sailingaround/mppt/README.md

# Mppt with rs485 status output
This is a small circuit providing an mppt power converter with these requirements:

 - up to 60v input
 - charge two lead-acid batteries (24V) (one should also be possible)
 - up to 4A current
 - rs485 status output for board computer
