sailingaround/mppt/mppt.kicad_pcb

## KiCad design mppt.kicad_pcb (2017-03-02)

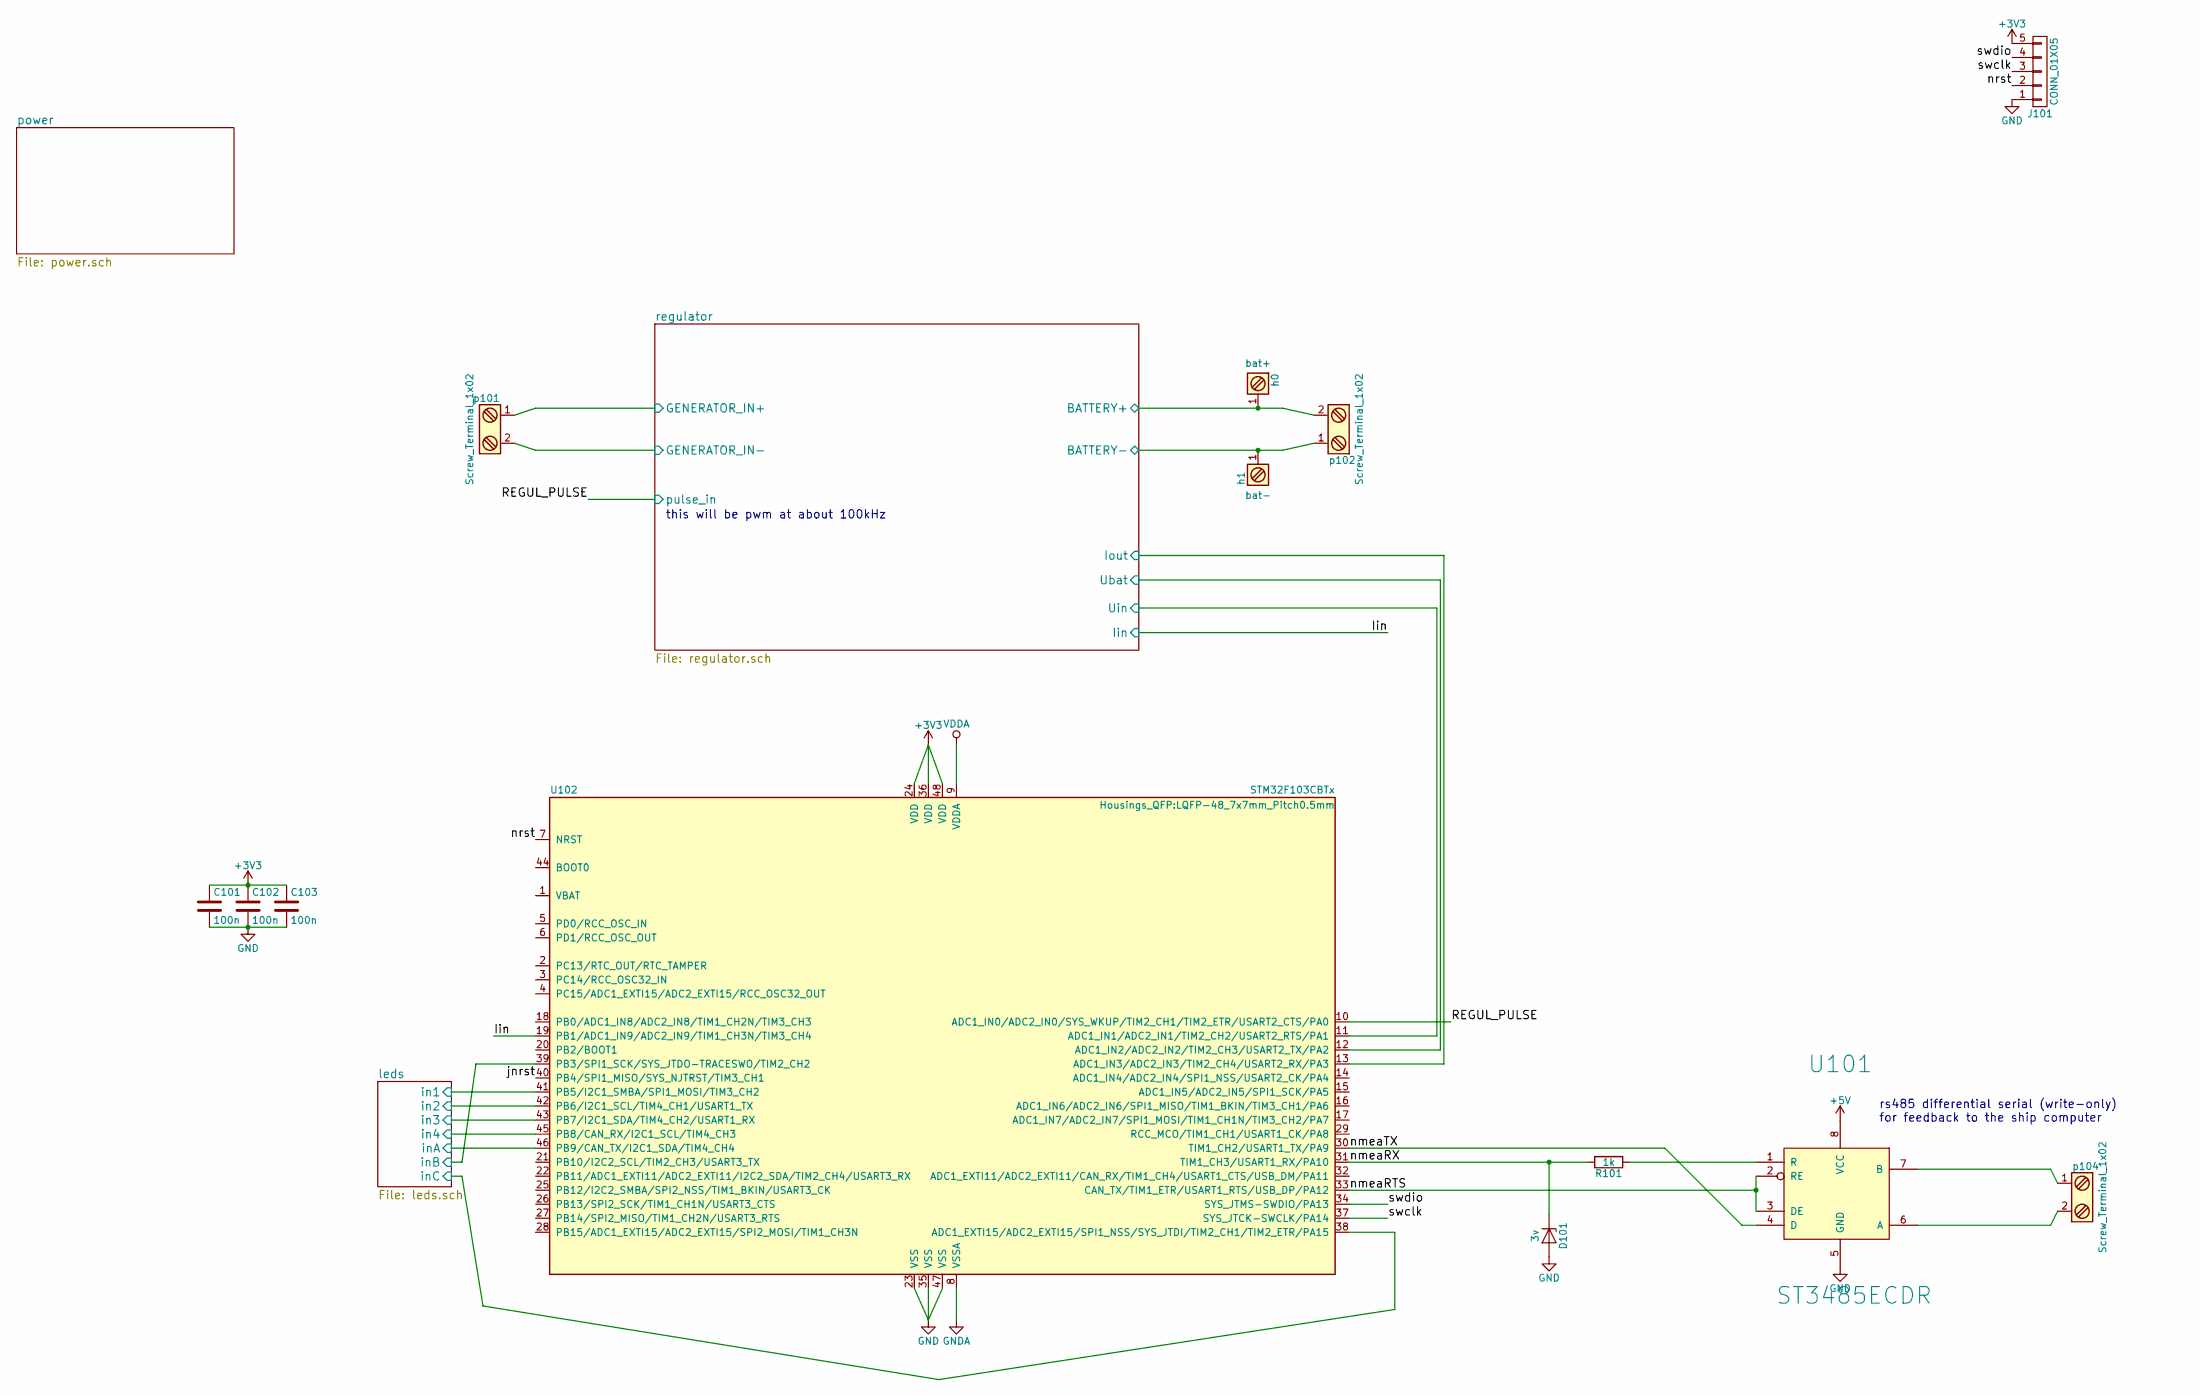
[picture p1: schematic mppt.sch]

Parts:
C101, C102, C103: 100n; C_0805
D101: 3v; D_SOD-323_HandSoldering; farnell 2441312
J101: CONN_01X05; swd_conn
R101: 1k; R_0805
U101: ST3485ECDR; SOIC-8_3.9x4.9mm_Pitch1.27mm; farnell 1842628
U102: STM32F103CBTx; LQFP-48_7x7mm_Pitch0.5mm
h0: bat+; m4_hole
h1: bat-; m4_hole
p101, p102, p104: Screw_Terminal_1x02; terminal

Connections:
+3V3: C101.1, C102.1, C103.1, J101.5, U102.24 (VDD), U102.36 (VDD), U102.48 (VDD); also elsewhere on the board
+5V: U101.8 (VCC); also elsewhere on the board
+24V: h0.1, p102.2; also elsewhere on the board
/Iin: U102.19 (PB1/ADC1_IN9/ADC2_IN9/TIM1_CH3N/TIM3_CH4); also elsewhere on the board
/REGUL_PULSE: U102.10 (ADC1_IN0/ADC2_IN0/SYS_WKUP/TIM2_CH1/TIM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); also elsewhere on the board
/leds/in1: U102.41 (PB5/I2C1_SMBA/SPI1_MOSI/TIM3_CH2); also elsewhere on the board
/leds/in2: U102.42 (PB6/I2C1_SCL/TIM4_CH1/USART1_TX); also elsewhere on the board
/leds/in3: U102.43 (PB7/I2C1_SDA/TIM4_CH2/USART1_RX); also elsewhere on the board
/leds/in4: U102.45 (PB8/CAN_RX/I2C1_SCL/TIM4_CH3); also elsewhere on the board
/leds/inA: U102.46 (PB9/CAN_TX/I2C1_SDA/TIM4_CH4); also elsewhere on the board
/leds/inB: U102.39 (PB3/SPI1_SCK/SYS_JTDO-TRACESWO/TIM2_CH2); also elsewhere on the board
/leds/inC: U102.38 (ADC1_EXTI15/ADC2_EXTI15/SPI1_NSS/SYS_JT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); also elsewhere on the board
/nmeaRTS: U101.2 (RE), U101.3 (DE), U102.33 (CAN_TX/TIM1_ETR/USART1_RTS/USB_DP/PA12)
/nmeaRX: D101.1 (K), R101.2, U102.31 (TIM1_CH3/USART1_RX/PA10)
/nmeaTX: U101.4 (D), U102.30 (TIM1_CH2/USART1_TX/PA9)
/nrst: J101.2, U102.7 (NRST)
/regulator/BATTERY-: h1.1, p102.1; also elsewhere on the board
/regulator/GENERATOR_IN+: p101.1; also elsewhere on the board
/regulator/GENERATOR_IN-: p101.2; also elsewhere on the board
/regulator/Iout: U102.13 (ADC1_IN3/ADC2_IN3/TIM2_CH4/USART2_RX/PA3); also elsewhere on the board
/regulator/Ubat: U102.12 (ADC1_IN2/ADC2_IN2/TIM2_CH3/USART2_TX/PA2); also elsewhere on the board
/regulator/Uin: U102.11 (ADC1_IN1/ADC2_IN1/TIM2_CH2/USART2_RTS/P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); also elsewhere on the board
/swclk: J101.3, U102.37 (SYS_JTCK-SWCLK/PA14)
/swdio: J101.4, U102.34 (SYS_JTMS-SWDIO/PA13)
GND: C101.2, C102.2, C103.2, D101.2 (A), J101.1, U101.5 (GND), U102.23 (VSS), U102.35 (VSS), U102.47 (VSS); also elsewhere on the board
GNDA: U102.8 (VSSA); also elsewhere on the board
unnamed: R101.1, U101.1 (R)
unnamed: U101.6 (A), p104.2
unnamed: U101.7 (B), p104.1
VDDA: U102.9 (VDDA); also elsewhere on the board

Notes on the sheet:
rs485 differential serial (write-only) for feedback to the ship computer
this will be pwm at about 100kHz

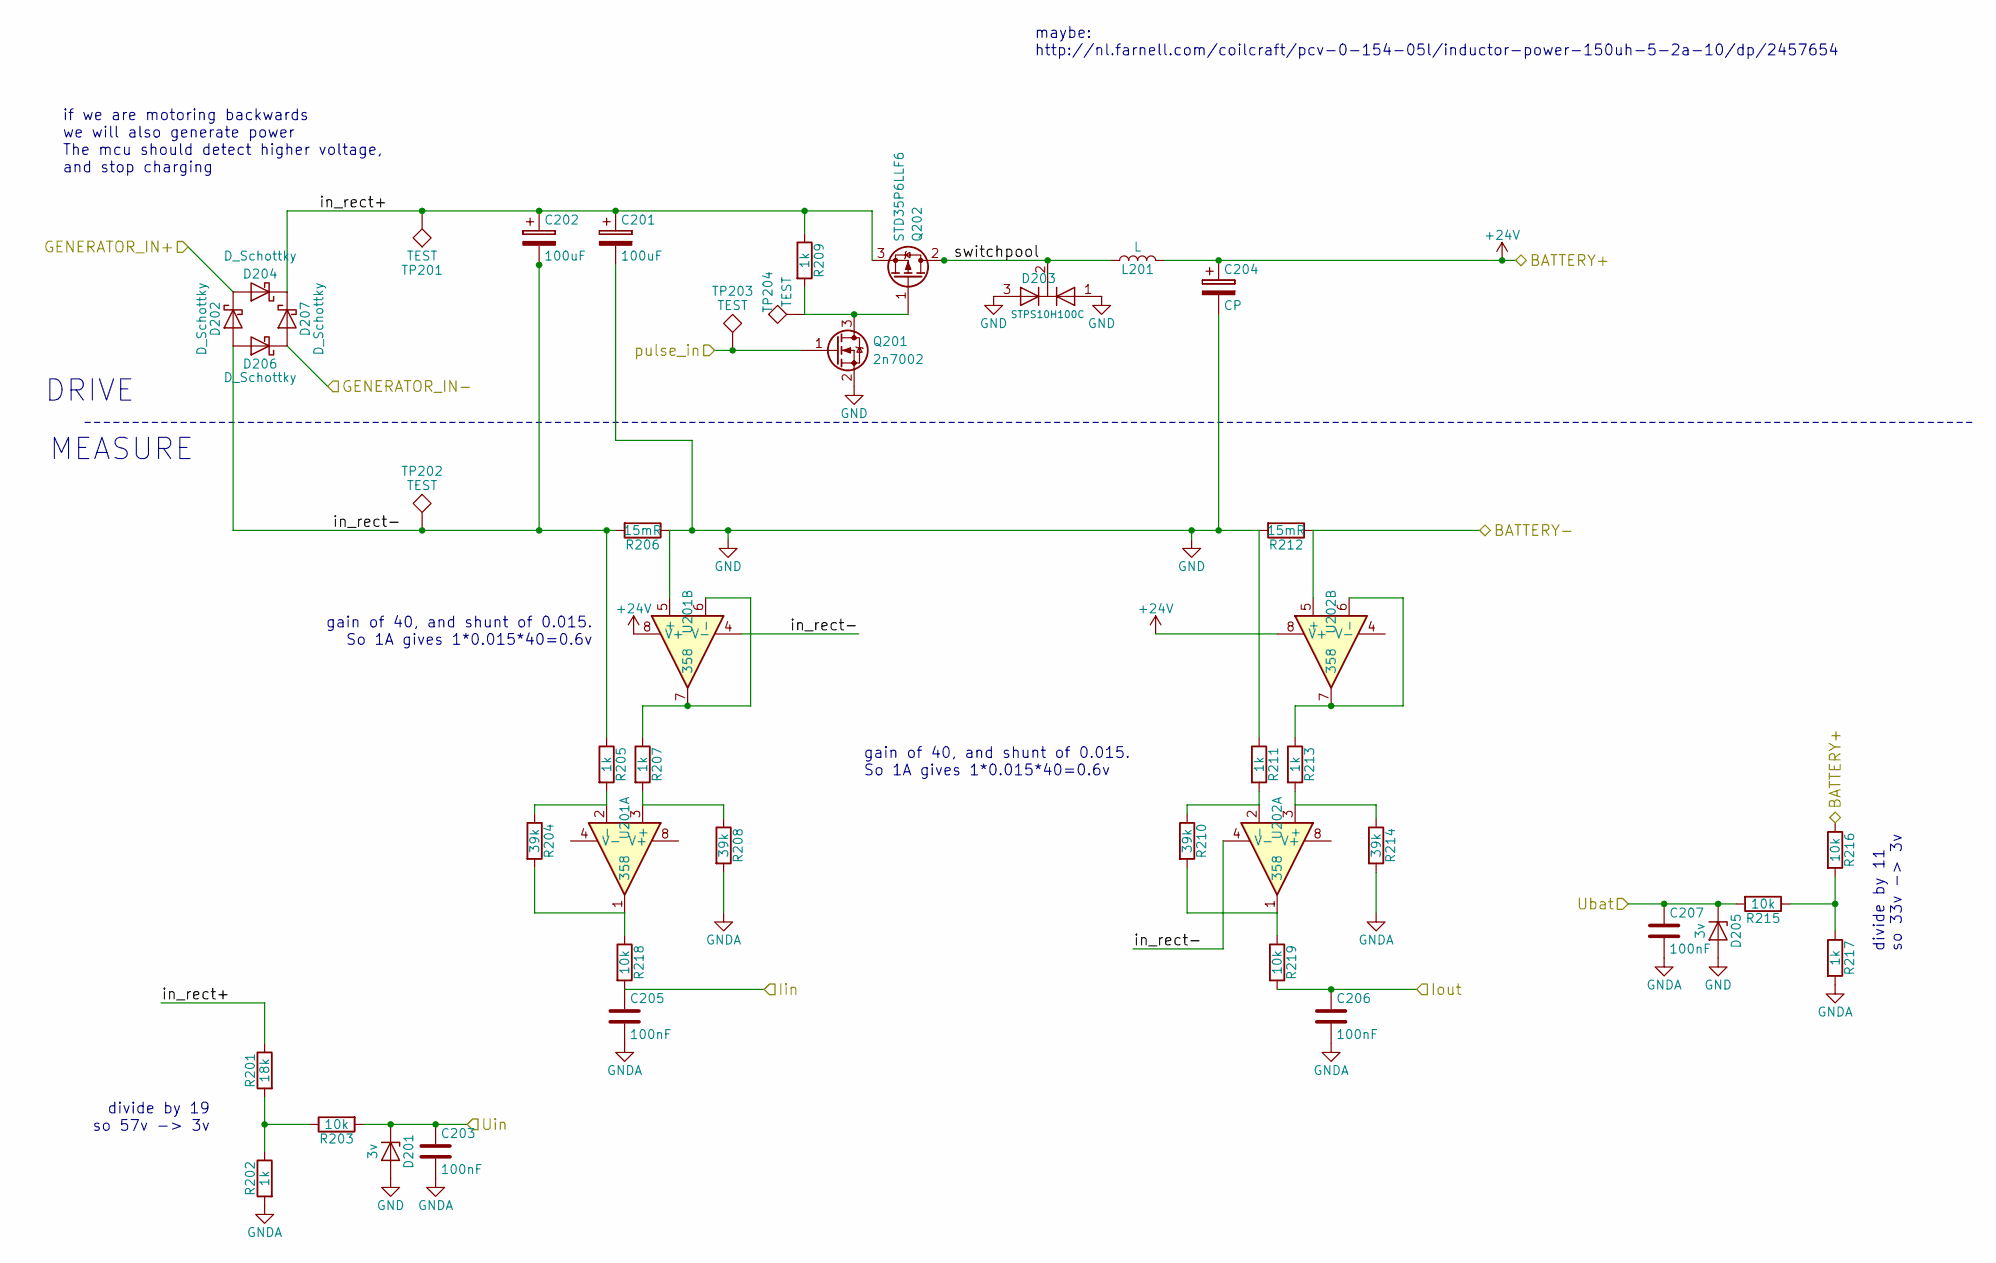
[picture p2: schematic regulator.sch]

Parts:
C201, C202: 100uF; CP_Radial_D10.0mm_P2.50mm; farnell 1281843
C203, C205, C206, C207: 100nF; C_0805
C204: CP; CP_Radial_D8.0mm_P5.00mm
D201, D205: 3v; D_SOD-323_HandSoldering; farnell 2441312
D202, D204, D206, D207: D_Schottky; Diode_DO-201AD_Vertical; farnell 1859669
D203: STPS10H100C; TO-220_Vertical
L201: L; toroid; farnell 1077015
Q201: 2n7002; SOT-23
Q202: STD35P6LLF6; TO-252-2Lead
R201: 18k; R_0805
R202, R205, R207, R209, R211, R213, R217: 1k; R_0805
R203, R215, R216, R218, R219: 10k; R_0805
R204, R208, R210, R214: 39k; R_0805
R206: 15mR; R_1206
R212: 15mR; R_1206_HandSoldering
TP201, TP202, TP203, TP204: TEST; Measurement_Point_Round-SMD-Pad_Big
U201, U202: 358; SOIC-8_3.9x4.9mm_Pitch1.27mm

Connections:
+24V: C204.1, L201.2, R216.1, U201.8 (V+), U202.8 (V+); also elsewhere on the board
/Iin: C205.1, R218.2; also elsewhere on the board
/REGUL_PULSE: Q201.1 (G), TP203.1; also elsewhere on the board
/regulator/BATTERY-: R212.1, U202.5 (+); also elsewhere on the board
/regulator/GENERATOR_IN+: D202.1 (K), D204.2 (A); also elsewhere on the board
/regulator/GENERATOR_IN-: D206.1 (K), D207.2 (A); also elsewhere on the board
/regulator/Iout: C206.1, R219.2; also elsewhere on the board
/regulator/Ubat: C207.1, D205.1 (K), R215.2; also elsewhere on the board
/regulator/Uin: C203.1, D201.1 (K), R203.2; also elsewhere on the board
/regulator/in_rect+: C201.1, C202.1, D204.1 (K), D207.1 (K), Q202.3 (S), R201.1, R209.1, TP201.1
/regulator/in_rect-: C202.2, D202.2 (A), D206.2 (A), R205.1, R206.2, TP202.1, U201.4 (V-), U202.4 (V-)
/regulator/switchpool: D203.2 (K), L201.1, Q202.2 (D)
GND: C201.2, C204.2, D201.2 (A), D203.1 (A), D203.3 (A), D205.2 (A), Q201.2 (S), R206.1, R211.1, R212.2, U201.5 (+); also elsewhere on the board
GNDA: C203.2, C205.2, C206.2, C207.2, R202.2, R208.2, R214.2, R217.2; also elsewhere on the board
unnamed: Q201.3 (D), Q202.1 (G), R209.2, TP204.1
unnamed: R201.2, R202.1, R203.1
unnamed: R204.1, R205.2, U201.2 (-)
unnamed: R204.2, R218.1, U201.1
unnamed: R207.1, U201.6 (-), U201.7
unnamed: R207.2, R208.1, U201.3 (+)
unnamed: R210.1, R211.2, U202.2 (-)
unnamed: R210.2, R219.1, U202.1
unnamed: R213.1, U202.6 (-), U202.7
unnamed: R213.2, R214.1, U202.3 (+)
unnamed: R215.1, R216.2, R217.1

Notes on the sheet:
divide by 19 so 57v -> 3v
if we are motoring backwards we will also generate power The mcu should detect higher voltage, and stop charging
divide by 11 so 33v -> 3v
DRIVE
MEASURE
gain of 40, and shunt of 0.015. So 1A gives 1*0.015*40=0.6v
maybe: http://nl.farnell.com/coilcraft/pcv-0-154-05l/inductor-power-150uh-5-2a-10/dp/2457654

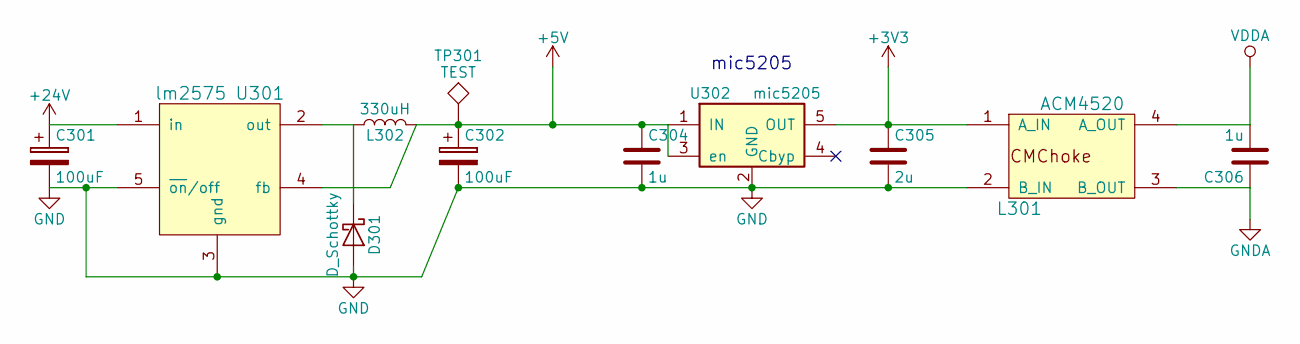
[picture p3: schematic power.sch]

Parts:
C301: 100uF; CP_Radial_D10.0mm_P2.50mm
C302: 100uF; CP_Radial_D8.0mm_P5.00mm
C304, C306: 1u; C_0805_HandSoldering
C305: 2u; C_0805_HandSoldering
D301: D_Schottky; D_DO-41_SOD81_P5.08mm_Vertical_KathodeUp
L301: ACM4520
L302: 330uH; 1212_inductor
TP301: TEST; Measurement_Point_Round-SMD-Pad_Big
U301: lm2575; TO-263-5Lead
U302: mic5205; SOT-23-5

Connections:
+3V3: C305.1, L301.1 (A_IN), U302.5 (OUT); also elsewhere on the board
+5V: C302.1, C304.1, L302.2, TP301.1, U301.4 (fb), U302.1 (IN), U302.3 (en); also elsewhere on the board
+24V: C301.1, U301.1 (in); also elsewhere on the board
GND: C301.2, C302.2, C304.2, C305.2, D301.2 (A), L301.2 (B_IN), U301.3 (gnd), U301.5 (~on~/off), U302.2 (GND); also elsewhere on the board
GNDA: C306.1, L301.3 (B_OUT); also elsewhere on the board
unnamed: D301.1 (K), L302.1, U301.2 (out)
VDDA: C306.2, L301.4 (A_OUT); also elsewhere on the board

Notes on the sheet:
mic5205

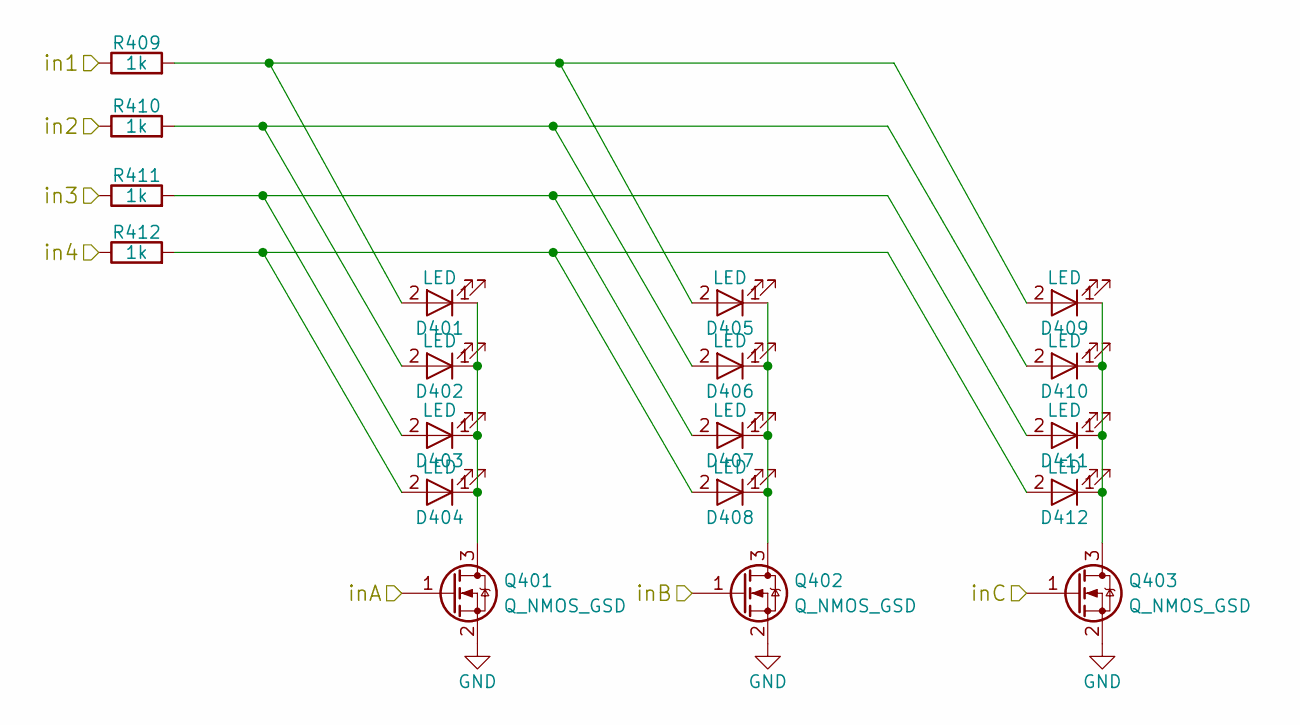
[picture p4: schematic leds.sch]

Parts:
D401, D402, D403, D404, D405, D406, D407, D408, D409, D410, D411, D412: LED; LED_0603
Q401, Q402, Q403: Q_NMOS_GSD; SOT-23_Handsoldering
R409, R410, R411, R412: 1k; R_0805

Connections:
/leds/in1: R409.1; also elsewhere on the board
/leds/in2: R410.1; also elsewhere on the board
/leds/in3: R411.1; also elsewhere on the board
/leds/in4: R412.1; also elsewhere on the board
/leds/inA: Q401.1 (G); also elsewhere on the board
/leds/inB: Q402.1 (G); also elsewhere on the board
/leds/inC: Q403.1 (G); also elsewhere on the board
GND: Q401.2 (S), Q402.2 (S), Q403.2 (S); also elsewhere on the board
unnamed: D401.1 (K), D402.1 (K), D403.1 (K), D404.1 (K), Q401.3 (D)
unnamed: D401.2 (A), D405.2 (A), D409.2 (A), R409.2
unnamed: D402.2 (A), D406.2 (A), D410.2 (A), R410.2
unnamed: D403.2 (A), D407.2 (A), D411.2 (A), R411.2
unnamed: D404.2 (A), D408.2 (A), D412.2 (A), R412.2
unnamed: D405.1 (K), D406.1 (K), D407.1 (K), D408.1 (K), Q402.3 (D)
unnamed: D409.1 (K), D410.1 (K), D411.1 (K), D412.1 (K), Q403.3 (D)

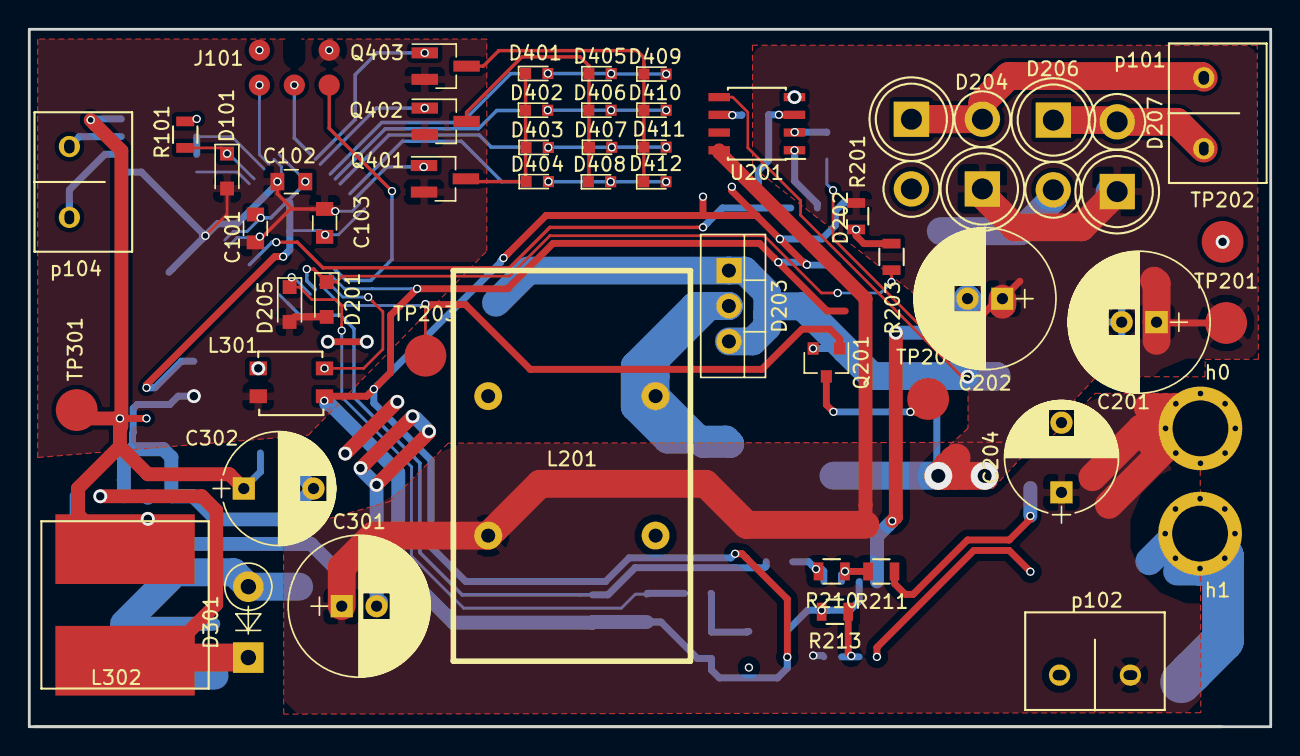
[picture p5: board mppt.kicad_pcb from above]

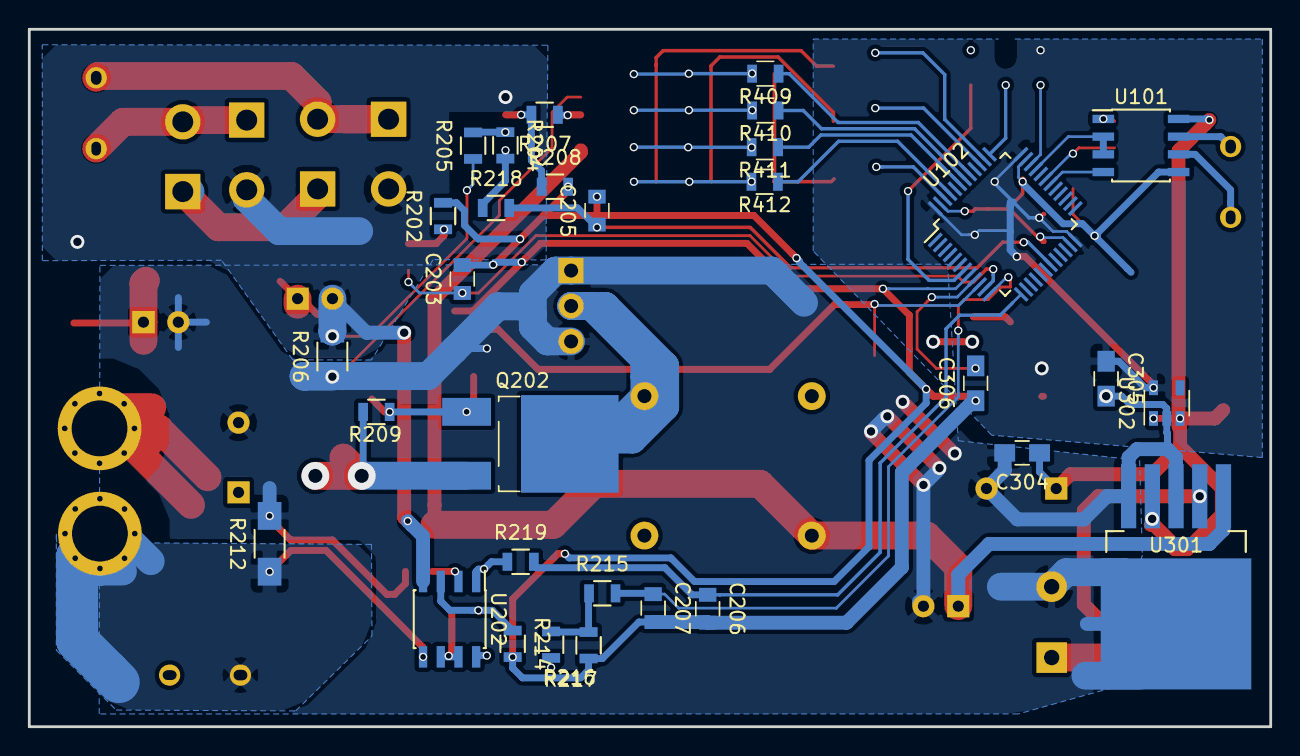
[picture p6: board mppt.kicad_pcb from below]

Board: 2 copper layers, 89.0 x 50.0 mm, 85 parts (31 on the bottom side), 52 nets.
