sailingaround/mppt/firmware/mppt_firmware/mppt_firmware.ioc

Mcu.UserName=STM32F103C8Tx
PA1.Signal=ADCx_IN1
PA10.Signal=USART1_RX
PA12.Signal=USART1_RTS
PA13.Signal=SYS_JTMS-SWDIO
PA14.Signal=SYS_JTCK-SWCLK
PA2.Signal=ADCx_IN2
PA3.Signal=ADCx_IN3
PA9.Signal=USART1_TX
PB0.Signal=ADCx_IN8
PB1.Signal=ADCx_IN9
PB5.GPIO_Label=led_red
PB5.Signal=GPIO_Output
PB6.GPIO_Label=led_green
PB6.Signal=GPIO_Input
