sailingaround/mppt/(commit log)

2016-12-24 Added inital version of the hardware.
    [mppt.kicad_pcb, mppt.sch, power.sch, regulator.sch]
2016-12-25 Changed a bit, and did a full re-route
    [mppt.kicad_pcb, mppt.sch, power.sch, regulator.sch]
2017-01-30 Routed for 5x5 pcb
    [mppt.kicad_pcb, mppt.sch, power.sch, regulator.sch]
2017-02-28 Rerouted, and made everything beautifull
    - added screw bolt-holes for the output.
    [mppt.kicad_pcb, mppt.sch, power.sch, regulator.sch]
2017-03-02 Added small display.
    And made everything look even nicer
    [leds.sch, mppt.kicad_pcb, mppt.sch, power.sch, regulator.sch]
